frenoy-osburn/u-nex/README.md

u-nex
=====

Design files, sample sketches, user guides for u-nex.
