frenoy-osburn/u-nex/Design_Files/u-nex_ICSP_SHIELD/u-nex_ICSP_SHIELD.brd

## EAGLE design Design_Files/u-nex_ICSP_SHIELD/u-nex_ICSP_SHIELD.brd (2014-05-11)

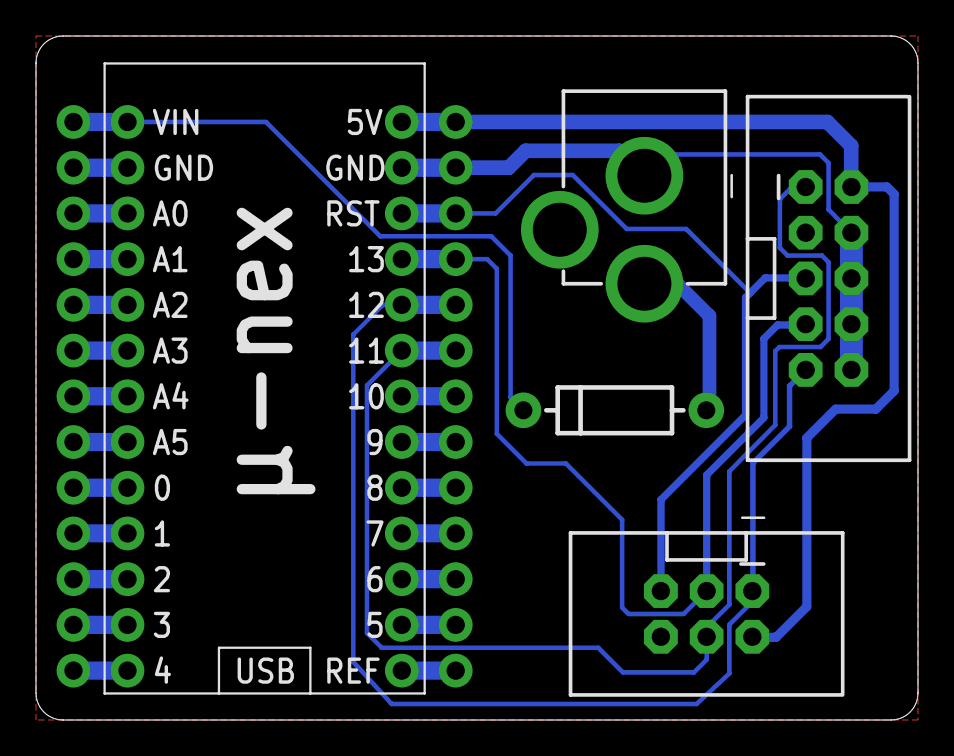
[picture p1: board u-nex_ICSP_SHIELD.brd from above]

Board: 2 copper layers, 49.0 x 38.0 mm, 7 parts (0 on the bottom side), 26 nets.

Parts:
D1: DIODE-1N4001
J2: POWER_JACKPTH; POWER_JACK_PTH
U$1, U$4: M13; 1X13
U$2: AVR_SPI_PROG2PTH2; 2X5-SHROUDED
U$6: AVR_ICSP_6; 2X3_SHROUDED
U$10: U-NEX

Connections:
5V0: U$2.2, U$4.13, U$6.2, U$10.5V
A0: U$1.11, U$10.A0
A1: U$1.10, U$10.A1
A2: U$1.9, U$10.A2
A3: U$1.8, U$10.A3
A4: U$1.7, U$10.A4
A5: U$1.6, U$10.A5
D0: U$1.5, U$10.0
D1: U$1.4, U$10.1
D2: U$1.3, U$10.2
D3: U$1.2, U$10.3
D4: U$1.1, U$10.4
D5: U$4.2, U$10.5
D6: U$4.3, U$10.6
D7: U$4.4, U$10.7
D8: U$4.5, U$10.8
D9: U$4.6, U$10.9
D10: U$4.7, U$10.10
GND: J2.GND, U$1.12, U$2.4, U$2.6, U$2.8, U$2.10, U$4.12, U$6.6, U$10.GND, U$10.GND2
MISO: U$2.9, U$4.9, U$6.1, U$10.12
MOSI: U$2.1, U$4.8, U$6.4, U$10.11
unnamed: D1.A, J2.PWR
REF: U$4.1, U$10.REF
RST: U$2.5, U$4.11, U$6.5, U$10.RST
SCK: U$2.7, U$4.10, U$6.3, U$10.13
VIN: D1.C, U$1.13, U$10.VIN
