frenoy-osburn/u-nex/Design_Files/u-nex_MOTOR_SHIELD/u-nex_MOTOR_SHIELD.brd

## EAGLE design Design_Files/u-nex_MOTOR_SHIELD/u-nex_MOTOR_SHIELD.brd (2014-05-11)

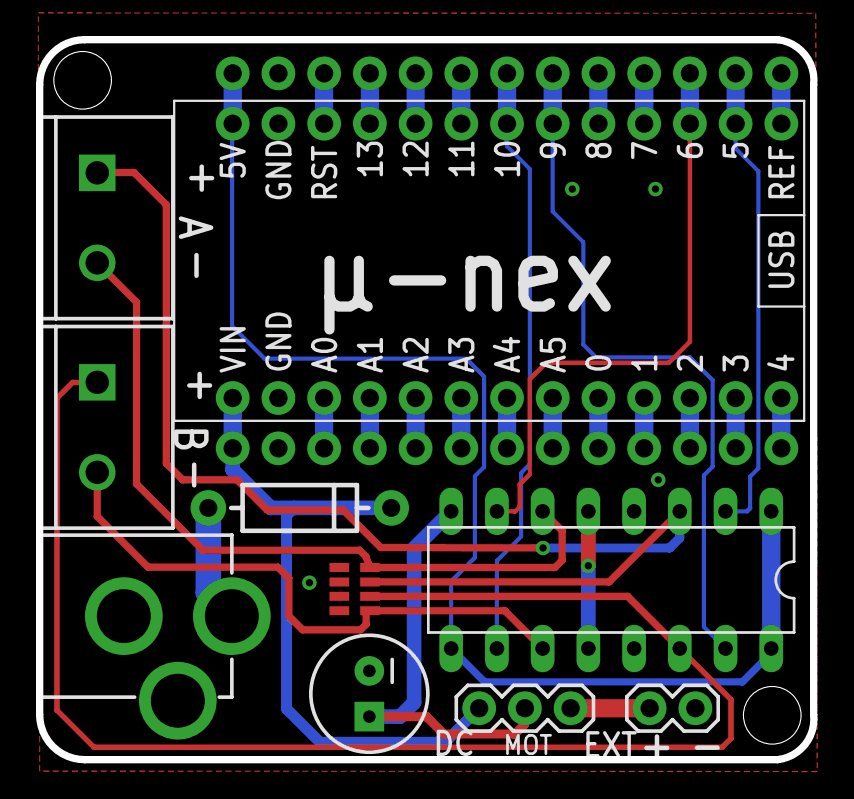
[picture p2: board u-nex_MOTOR_SHIELD.brd from above]

Board: 2 copper layers, 43.0 x 40.0 mm, 12 parts (0 on the bottom side), 32 nets.

Parts:
C2: 100uF; CPOL-RADIAL-100UF-25V
D1: DIODE-1N4001
IC1: L293D; DIL16
J2: POWER_JACKPTH; POWER_JACK_PTH
JP1: M02PTH; 1X02
JP2: 1X03
JP4, JP5: M025MM; SCREWTERMINAL-5MM-2
U$1, U$4: M13; 1X13
U$2: 0.1uF; 0603_ARV
U$10: U-NEX

Connections:
5V0: IC1.1, IC1.9, IC1.16, U$1.13, U$10.5V
A0: U$4.11, U$10.A0
A1: U$4.10, U$10.A1
A2: U$4.9, U$10.A2
A3: U$4.8, U$10.A3
A4: U$4.7, U$10.A4
A5: U$4.6, U$10.A5
D0: U$4.5, U$10.0
D1: U$4.4, U$10.1
D2: U$4.3, U$10.2
D3: U$4.2, U$10.3
D4: U$4.1, U$10.4
D7: U$1.4, U$10.7
D8: U$1.5, U$10.8
D11: U$1.8, U$10.11
D12: U$1.9, U$10.12
D13: U$1.10, U$10.13
GND: C2.2, IC1.4, IC1.5, IC1.12, IC1.13, J2.GND, JP1.2, U$1.12, U$2.5, U$2.6, U$2.7, U$2.8, U$4.12, U$10.GND, U$10.GND2
MOT_A_+: IC1.3, JP4.1, U$2.3
MOT_A_-: IC1.6, JP4.2, U$2.4
MOT_B_+: IC1.14, JP5.1, U$2.2
MOT_B_-: IC1.11, JP5.2, U$2.1
PWM_A_+: IC1.2, U$1.2, U$10.5
PWM_A_-: IC1.7, U$1.3, U$10.6
PWM_B_+: IC1.15, U$1.6, U$10.9
PWM_B_-: IC1.10, U$1.7, U$10.10
RAW_PWR: D1.A, J2.PWR
REF: U$1.1, U$10.REF
RST: U$1.11, U$10.RST
VEXT: JP1.1, JP2.1
VIN: D1.C, JP2.3, U$4.13, U$10.VIN
VMOT: C2.1, IC1.8, JP2.2
