frenoy-osburn/u-nex/Design_Files/u-nex_SHIELD_SHIELD/u-nex_SHIELD_SHIELD.brd

## EAGLE design Design_Files/u-nex_SHIELD_SHIELD/u-nex_SHIELD_SHIELD.brd (2014-05-11)

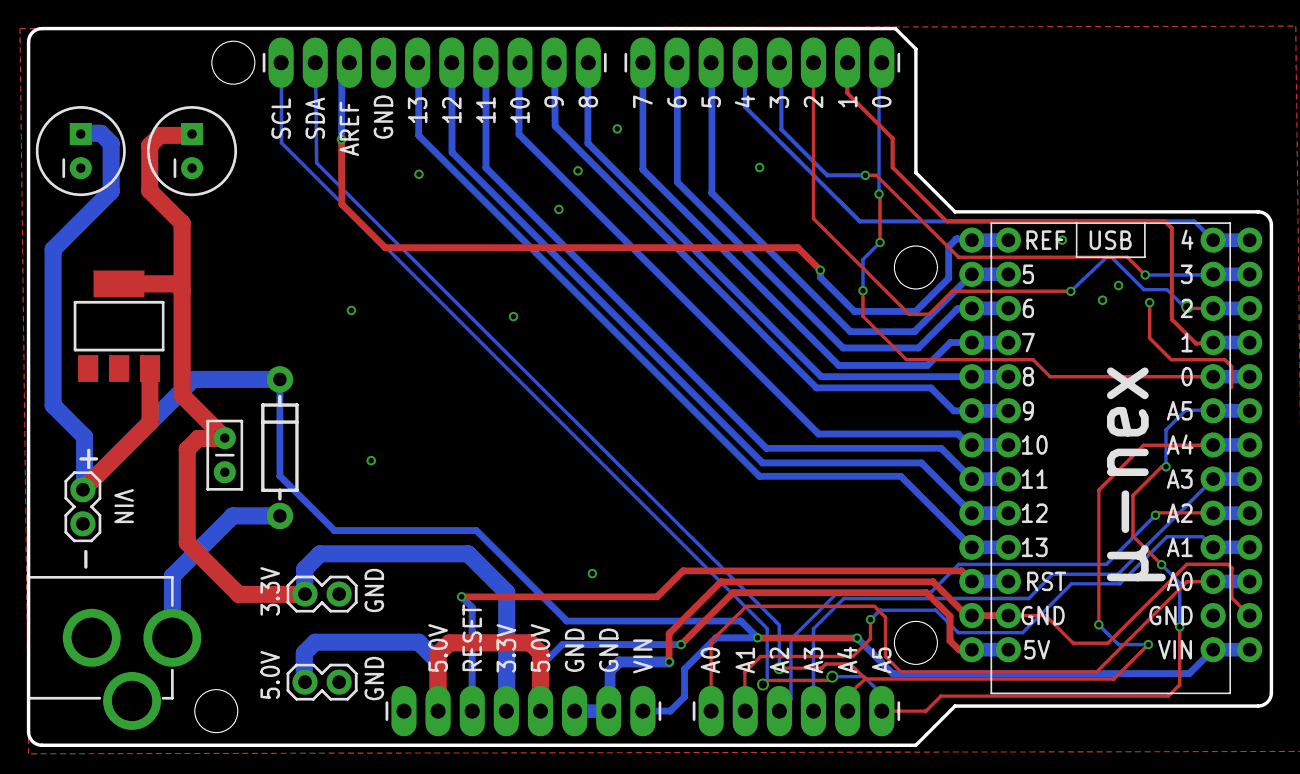
[picture p3: board u-nex_SHIELD_SHIELD.brd from above]

Board: 2 copper layers, 92.5 x 53.3 mm, 16 parts (0 on the bottom side), 27 nets.

Parts:
C1: 47uF; CPOL-RADIAL-100UF-25V
C2: 1uF; CPOL-RADIAL-100UF-25V
C3: 0.1uF; CAP-PTH-SMALLEZ
D1: DIODE-1N4001
IC2: LD117AS33TR; SOT223
J2: POWER_JACKPTH; POWER_JACK_PTH
JP1, JP4, JP7: M02PTH; 1X02
JP2, JP3: 1X08_LONGPADS
JP6: 1X06_LONGPADS
U$2, U$3: M13; 1X13
U$8: M1X10_LONGPADS; 1X10_LONGPADS
U$10: U-NEX

Connections:
3V3: C1.1, C3.1, IC2.4, JP1.1, JP3.4
5V0: JP3.2, JP3.5, JP4.1, U$3.13, U$10.5V
A0: JP6.1, U$2.11, U$10.A0
A1: JP6.2, U$2.10, U$10.A1
A2: JP6.3, U$2.9, U$10.A2
A3: JP6.4, U$2.8, U$10.A3
A4/SDA: JP6.5, U$2.7, U$8.9, U$10.A4
A5/SCL: JP6.6, U$2.6, U$8.10, U$10.A5
AREF: U$3.1, U$8.8, U$10.REF
D0/RX: JP2.1, U$2.5, U$10.0
D1/TX: JP2.2, U$2.4, U$10.1
D2: JP2.3, U$2.3, U$10.2
D3: JP2.4, U$2.2, U$10.3
D4: JP2.5, U$2.1, U$10.4
D5: JP2.6, U$3.2, U$10.5
D6: JP2.7, U$3.3, U$10.6
D7: JP2.8, U$3.4, U$10.7
GND: C1.2, C2.2, C3.2, IC2.1, J2.GND, JP1.2, JP3.6, JP3.7, JP4.2, JP7.2, U$2.12, U$3.12, U$8.7, U$10.GND, U$10.GND2
IO8: U$3.5, U$8.1, U$10.8
IO9: U$3.6, U$8.2, U$10.9
IO10: U$3.7, U$8.3, U$10.10
IO11: U$3.8, U$8.4, U$10.11
IO12: U$3.9, U$8.5, U$10.12
IO13: U$3.10, U$8.6, U$10.13
RAW_PWR: D1.A, J2.PWR
RST: JP3.3, U$3.11, U$10.RST
VIN: C2.1, D1.C, IC2.3, JP3.8, JP7.1, U$2.13, U$10.VIN
