frenoy-osburn/u-nex/Design_Files/u-nex_v1/u-nex_v1.brd

## EAGLE design Design_Files/u-nex_v1/u-nex_v1.brd (2014-05-11)

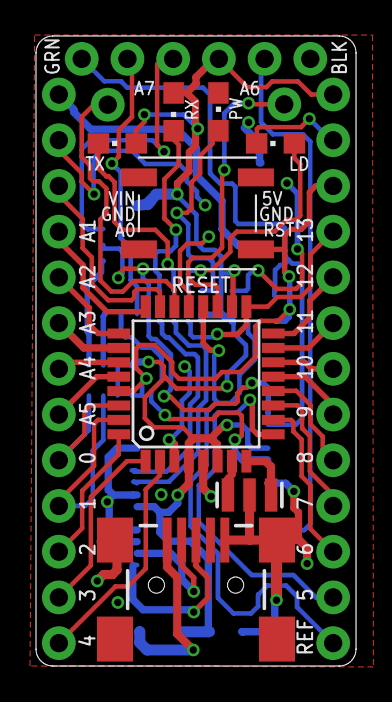
[picture p4: board u-nex_v1.brd from above]

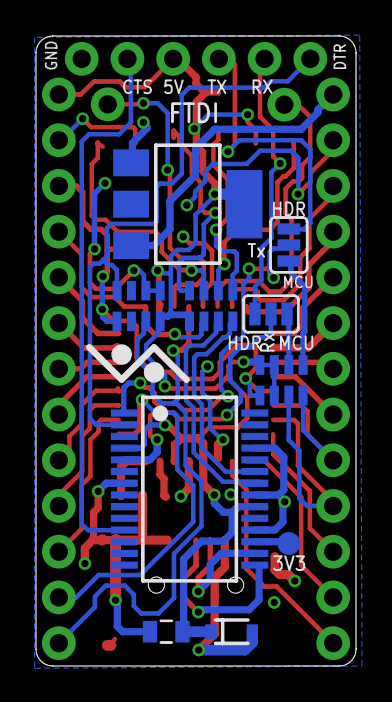
[picture p5: board u-nex_v1.brd from below]

Board: 2 copper layers, 17.8 x 35.0 mm, 23 parts (10 on the bottom side), 47 nets.

Parts:
C1: 0805
D1: SOD-323
IC1: FT232RL; SSOP28
IC2: LD117AS50TR; SOT223
JP1, JP2: 1X01_CLEAN
JP3, JP6: M13; 1X13
LED: CHIP; CHIPLED0805
PWR: RED; CHIPLED0805
R1: 1K; 0603_ARV
R2: 330; 0603_ARV
RX_LED: CHIPLED0805_SLIM; CHIPLED0805
SJ1, SJ2: SJ_3
TP1: TPB1,27; B1,27
TX_LED: CHIPLED0805_SLIM; CHIPLED0805
U4: ATMEGA328P; TQFP32-08
U$1: SWITCH_6.8X6.2
U$4: 0.1uF; 0603_ARV
U$5: 1X06_NO_MARKS; 1X06_CLEAN
U$9: USB-MINIB-5PIN; USB-MINIB
Y2: 16MHz; RESONATOR_SMD

Connections:
3V3: IC1.17, TP1.TP
5V0: C1.1, D1.1, IC1.4, IC1.20, IC2.4, JP6.13, R1.2, R1.7, R1.8, R2.1, RX_LED.A, TX_LED.A, U4.4, U4.6, U4.18, U$4.4, U$5.4
A0: JP3.11, U4.23
A1: JP3.10, U4.24
A2: JP3.9, U4.25
A3: JP3.8, U4.26
A4: JP3.7, U4.27
A5: JP3.6, U4.28
A6: JP1.1, U4.19
A7: JP2.1, U4.22
AREF: JP6.1, U4.20, U$4.3
CTS: IC1.11, U$5.5
D0: JP3.5, R1.4, U4.30
D1: JP3.4, R1.3, U4.31
D2: JP3.3, U4.32
D3: JP3.2, U4.1
D4: JP3.1, U4.2
D5: JP6.2, U4.9
D6: JP6.3, U4.10
D7: JP6.4, U4.11
D8: JP6.5, U4.12
D9: JP6.6, U4.13
D10: JP6.7, U4.14
D11: JP6.8, U4.15
D12: JP6.9, U4.16
D13: JP6.10, R2.2, U4.17
DTR: IC1.2, U$4.8, U$5.1
FTDI_RX_IN: IC1.5, SJ2.2
FTDI_TX_OUT: IC1.1, SJ1.2
GND: C1.2, IC1.7, IC1.18, IC1.21, IC1.25, IC2.1, JP3.12, JP6.12, LED.C, PWR.C, U4.3, U4.5, U4.21, U$1.1, U$4.5, U$4.6, U$5.6, U$9.GND, U$9.MTN1, U$9.MTN2, U$9.MTN3, U$9.MTN4, Y2.2
HDR_RX: SJ2.3, U$5.2
HDR_TX: SJ1.3, U$5.3
MCU_RESET: JP6.11, R1.1, U4.29, U$1.3, U$4.1
MCU_RX_IN: R1.5, SJ1.1
MCU_TX_OUT: R1.6, SJ2.1
unnamed: LED.A, R2.7
unnamed: R2.5, RX_LED.C
unnamed: R2.6, TX_LED.C
unnamed: IC1.22, R2.3
unnamed: IC1.23, R2.4
unnamed: PWR.A, R2.8
unnamed: U4.7, Y2.1
unnamed: U4.8, Y2.3
USB_DM: IC1.16, U$9.D-
USB_DP: IC1.15, U$9.D+
VIN: IC2.3, JP3.13
VUSB: D1.2, U$9.VBUS
