frenoy-osburn/u-nex/Design_Files/u-nex_RELAY_SHIELD/u-nex_RELAY_SHIELD.brd

## EAGLE design Design_Files/u-nex_RELAY_SHIELD/u-nex_RELAY_SHIELD.brd (2014-05-11)

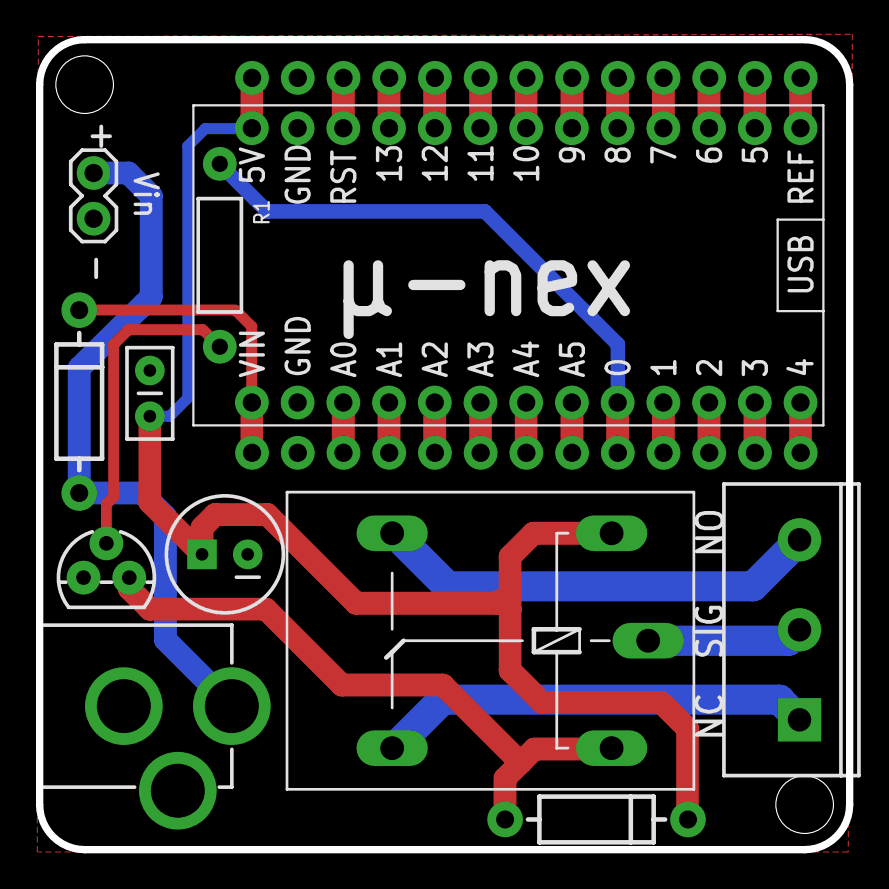
[picture p6: board u-nex_RELAY_SHIELD.brd from above]

Board: 2 copper layers, 45.0 x 45.0 mm, 13 parts (0 on the bottom side), 31 nets.

Parts:
C1: 0.1uF; CAP-PTH-SMALL2
C2: 100uF; CPOL-RADIAL-100UF-25V
D1, D2: 1N5817; DIODE-1N4001
J2: POWER_JACKPTH; POWER_JACK_PTH
JP1: M02PTH; 1X02
JP2: SCREWTERMINAL-5MM-3
K1: G5L; G5LE
Q1: TO-92
R1: AXIAL-0.4
U$1, U$4: M13; 1X13
U$2: U-NEX

Connections:
5V0: C1.1, C2.1, D2.C, K1.1, U$1.13, U$2.5V
A0: U$2.A0, U$4.11
A1: U$2.A1, U$4.10
A2: U$2.A2, U$4.9
A3: U$2.A3, U$4.8
A4: U$2.A4, U$4.7
A5: U$2.A5, U$4.6
D1: U$2.1, U$4.4
D2: U$2.2, U$4.3
D3: U$2.3, U$4.2
D4: U$2.4, U$4.1
D5: U$1.2, U$2.5
D6: U$1.3, U$2.6
D7: U$1.4, U$2.7
D8: U$1.5, U$2.8
D9: U$1.6, U$2.9
D10: U$1.7, U$2.10
D11: U$1.8, U$2.11
D12: U$1.9, U$2.12
D13: U$1.10, U$2.13
GND: C1.2, C2.2, J2.GND, JP1.2, Q1.1, U$1.12, U$2.GND, U$2.GND2, U$4.12
unnamed: D2.A, K1.2, Q1.3
unnamed: Q1.2, R1.P$2
NC: JP2.1, K1.O
NO: JP2.3, K1.S
RAW_PWR: D1.A, J2.PWR, JP1.1
REF: U$1.1, U$2.REF
RELAY: R1.P$1, U$2.0, U$4.5
RST: U$1.11, U$2.RST
SIG: JP2.2, K1.P
VIN: D1.C, U$2.VIN, U$4.13
