frenoy-osburn/u-nex/(commit log)

2014-05-11 Initial Release
    [u-nex_ICSP_SHIELD.brd, u-nex_ICSP_SHIELD.sch, u-nex_MOTOR_SHIELD.brd, u-nex_MOTOR_SHIELD.sch, u-nex_RELAY_SHIELD.brd, u-nex_RELAY_SHIELD.sch, u-nex_SHIELD_SHIELD.brd, u-nex_SHIELD_SHIELD.sch]
2014-08-01 Added support for ‘board.txt’ update in Mac OSX Fixes #2
